MicroRally/uDCCD-Controller/README.md

# uDCCD-Controller
 Simple DCCD controller, based on AVR Tiny
