MicroRally/uDCCD-Controller/Hardware/Main Board/r6/uDCCD_Controller_r6_Schematics.PDF

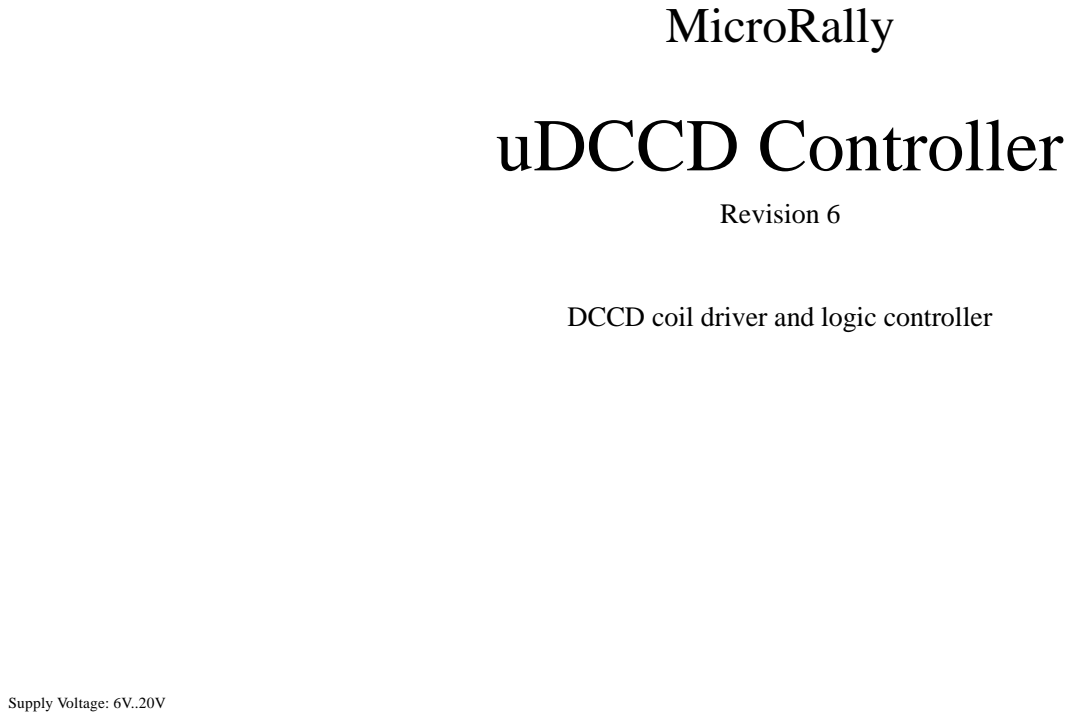
[picture p1: page 1]

DCCD coil driver and logic controller

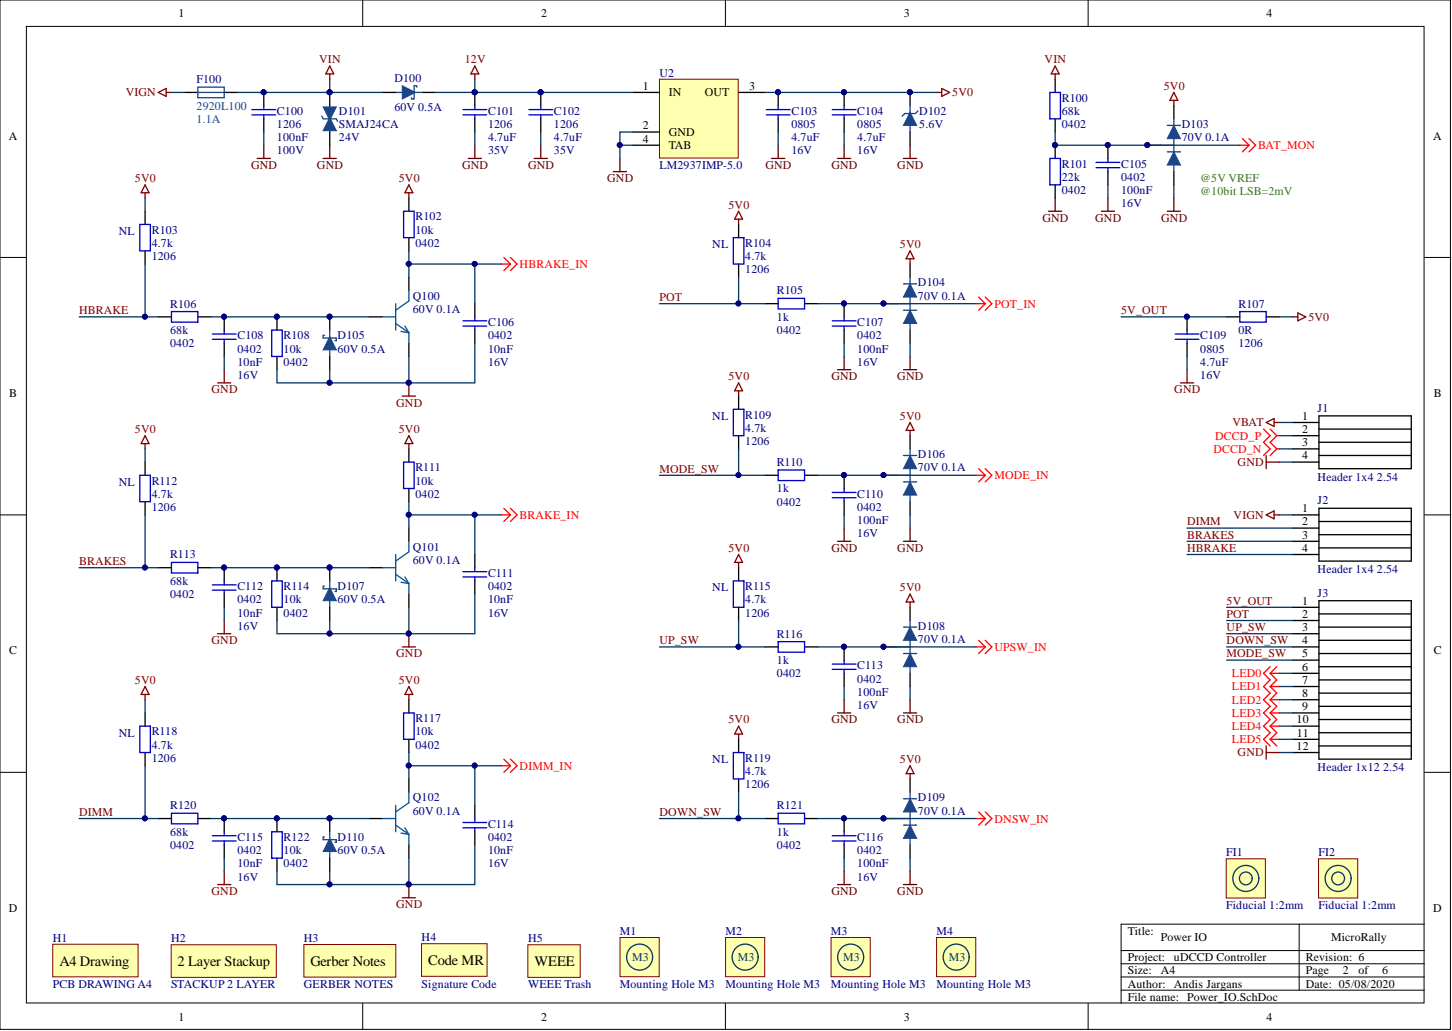
[picture p2: page 2]

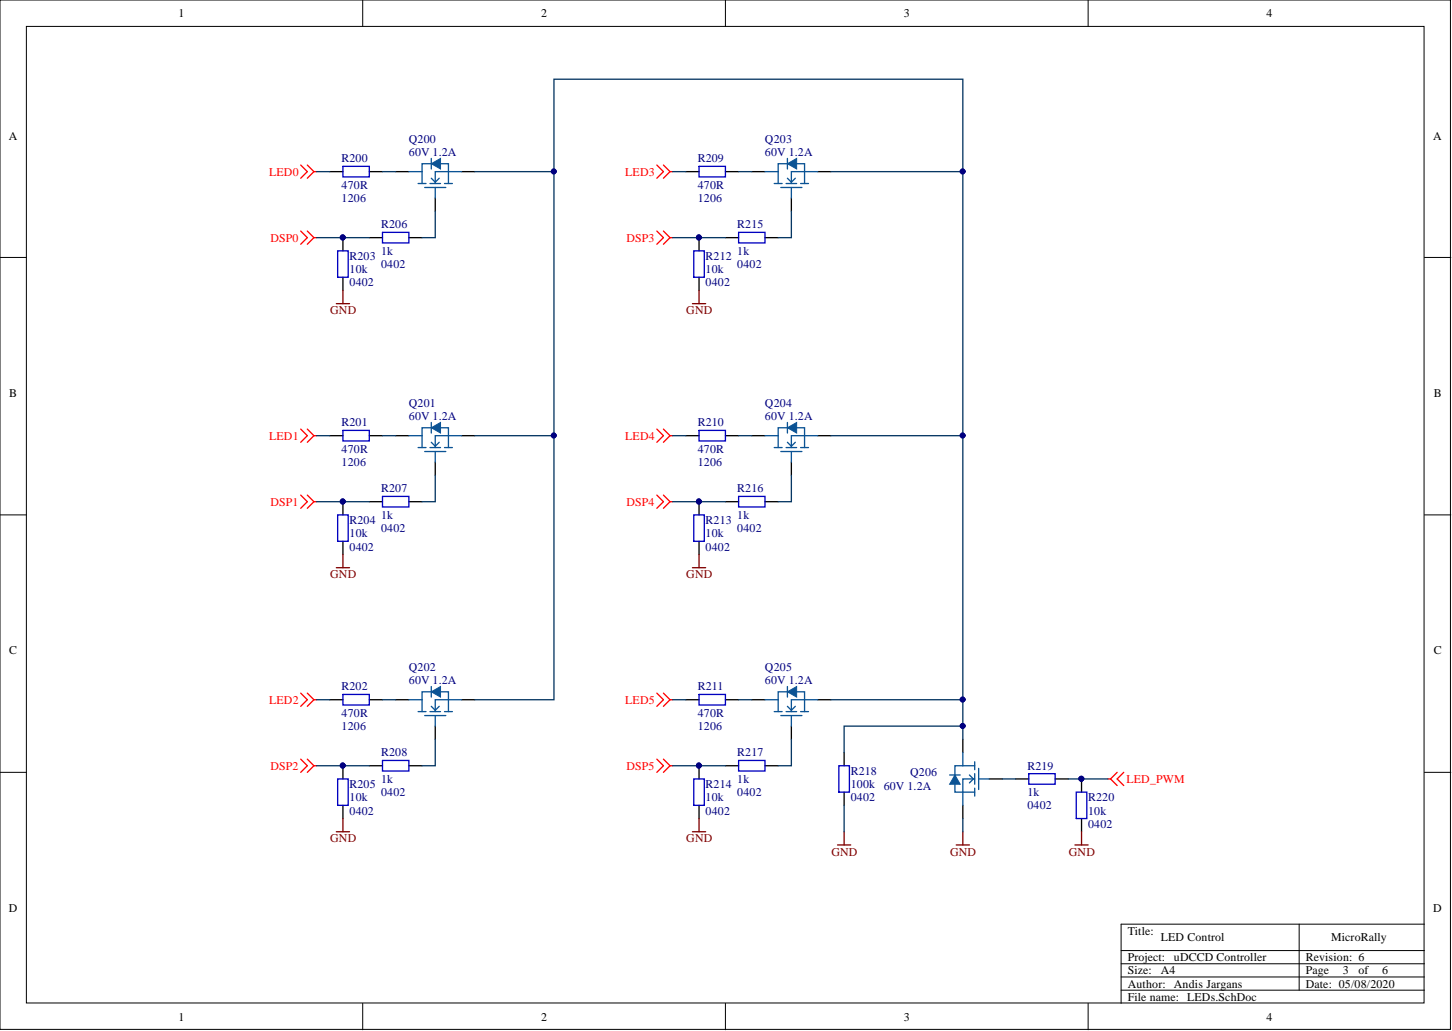
[picture p3: page 3]

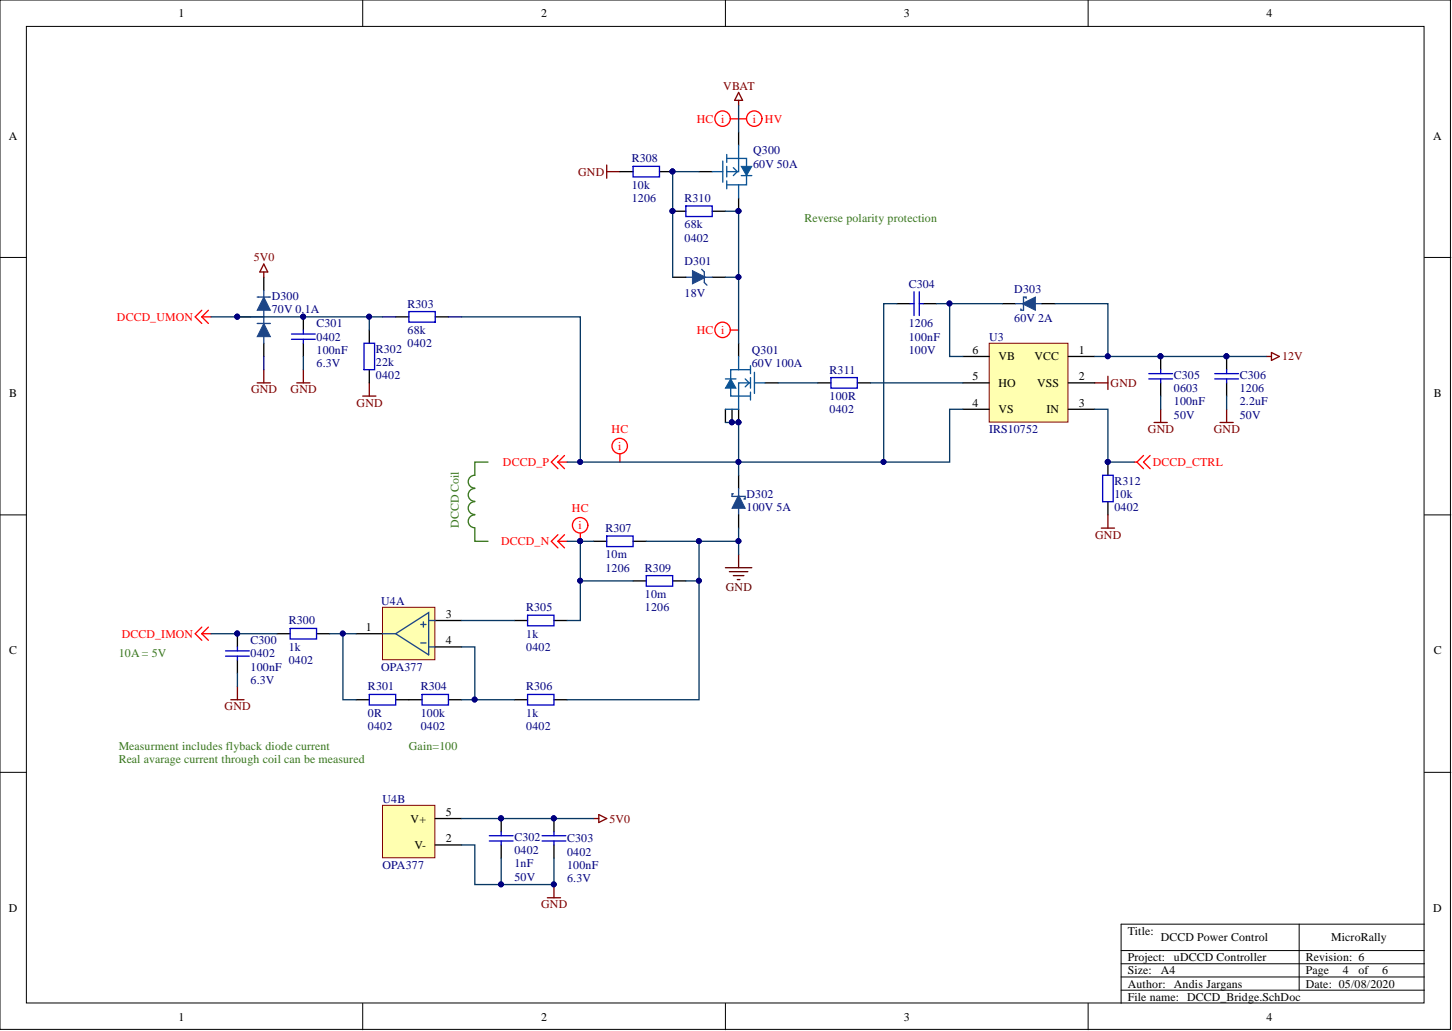
[picture p4: page 4]

Measurment includes flyback diode current
Real avarage current through coil can be measured

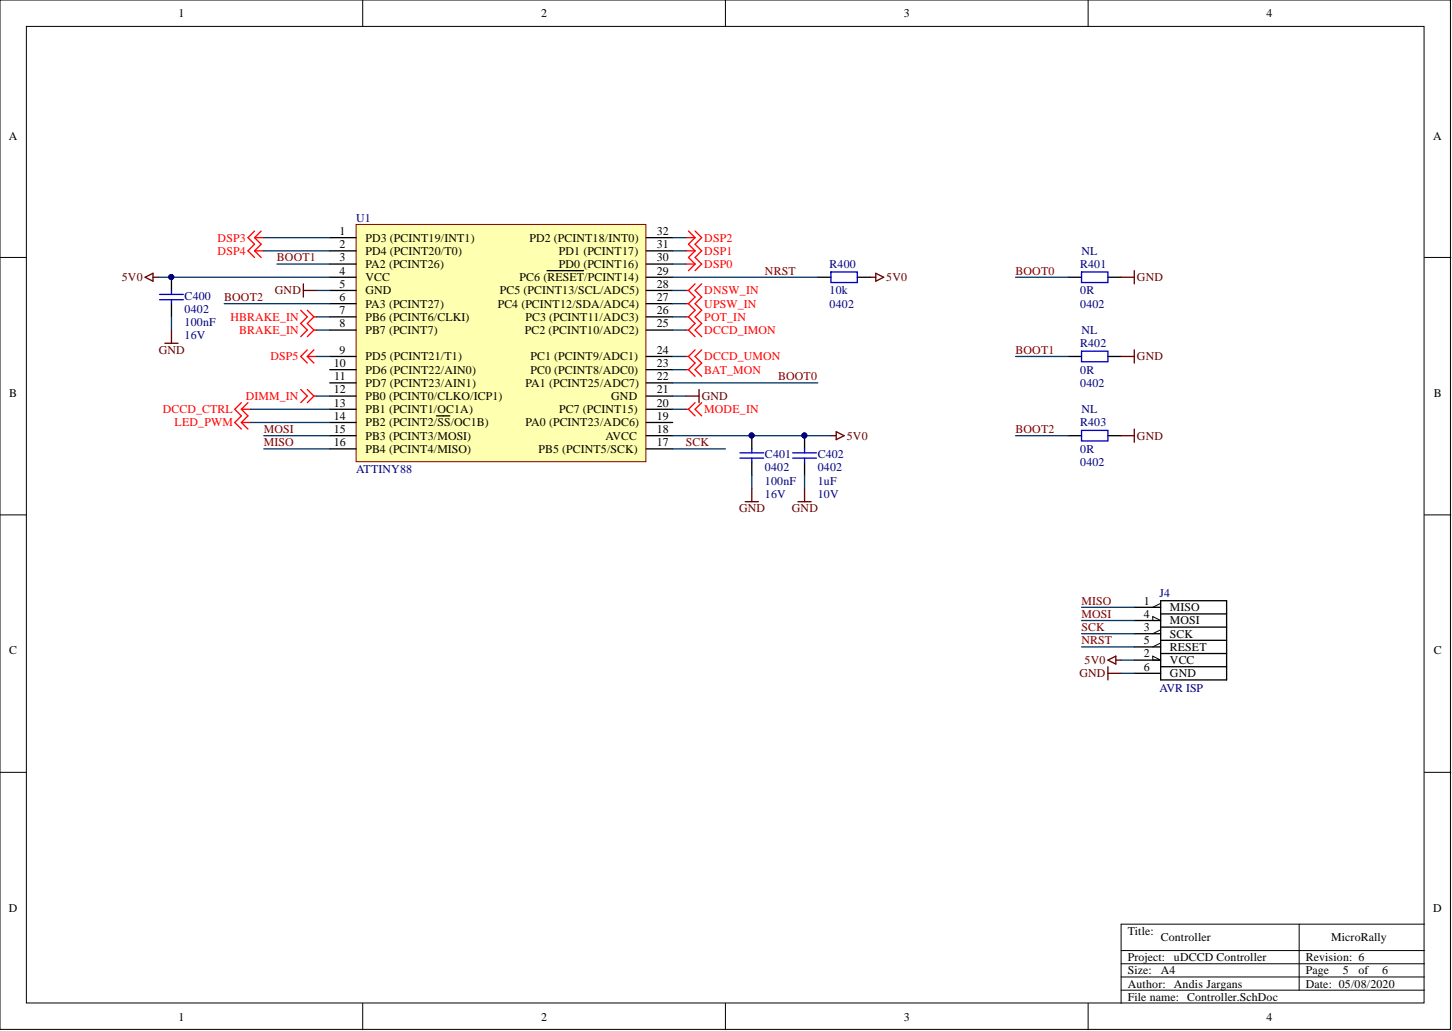
[picture p5: page 5]

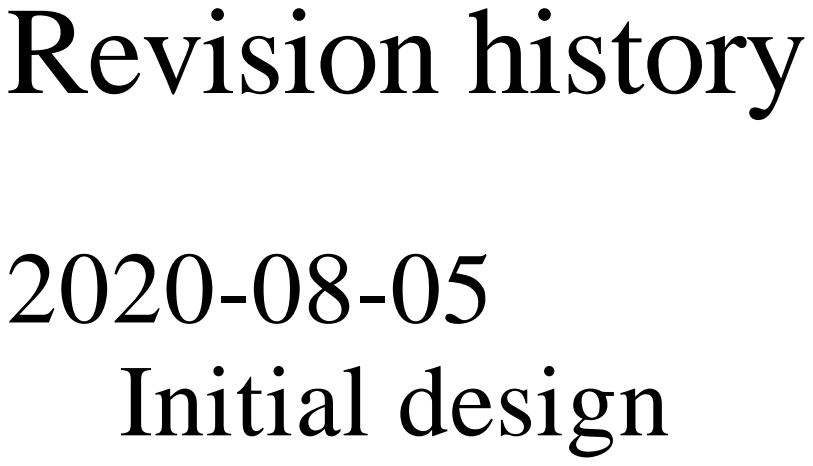
[picture p6: page 6]
