MicroRally/uDCCD-Controller/Hardware/Main Board/r7/uDCCD_Controller_r7_Schematics.PDF

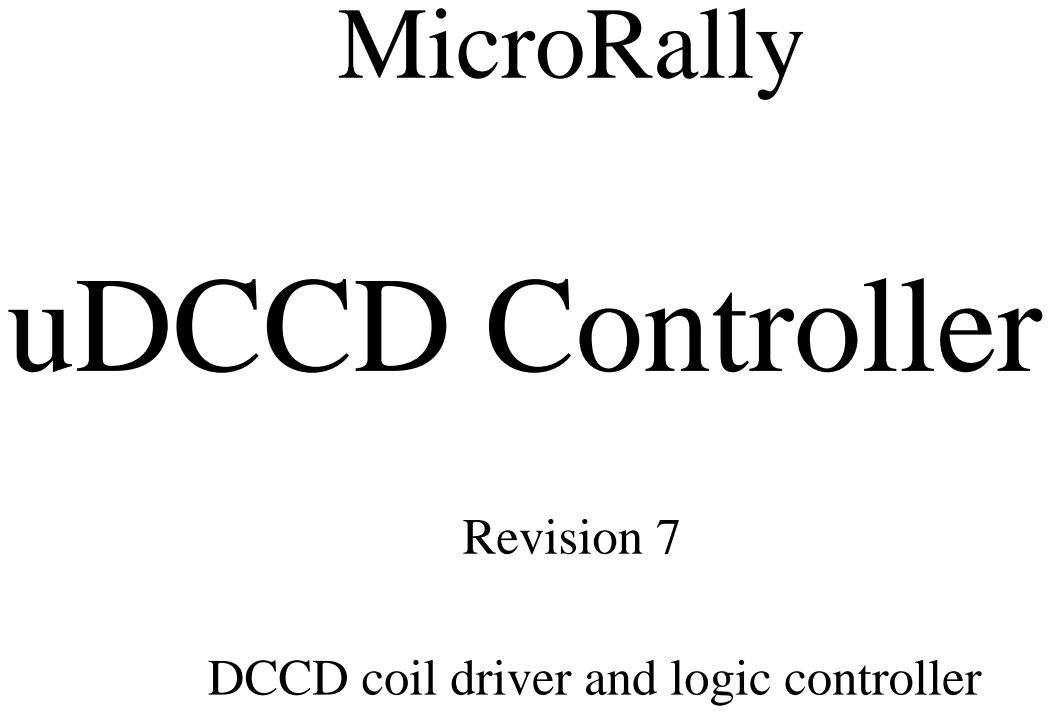
[picture p7: page 1]

DCCD coil driver and logic controller

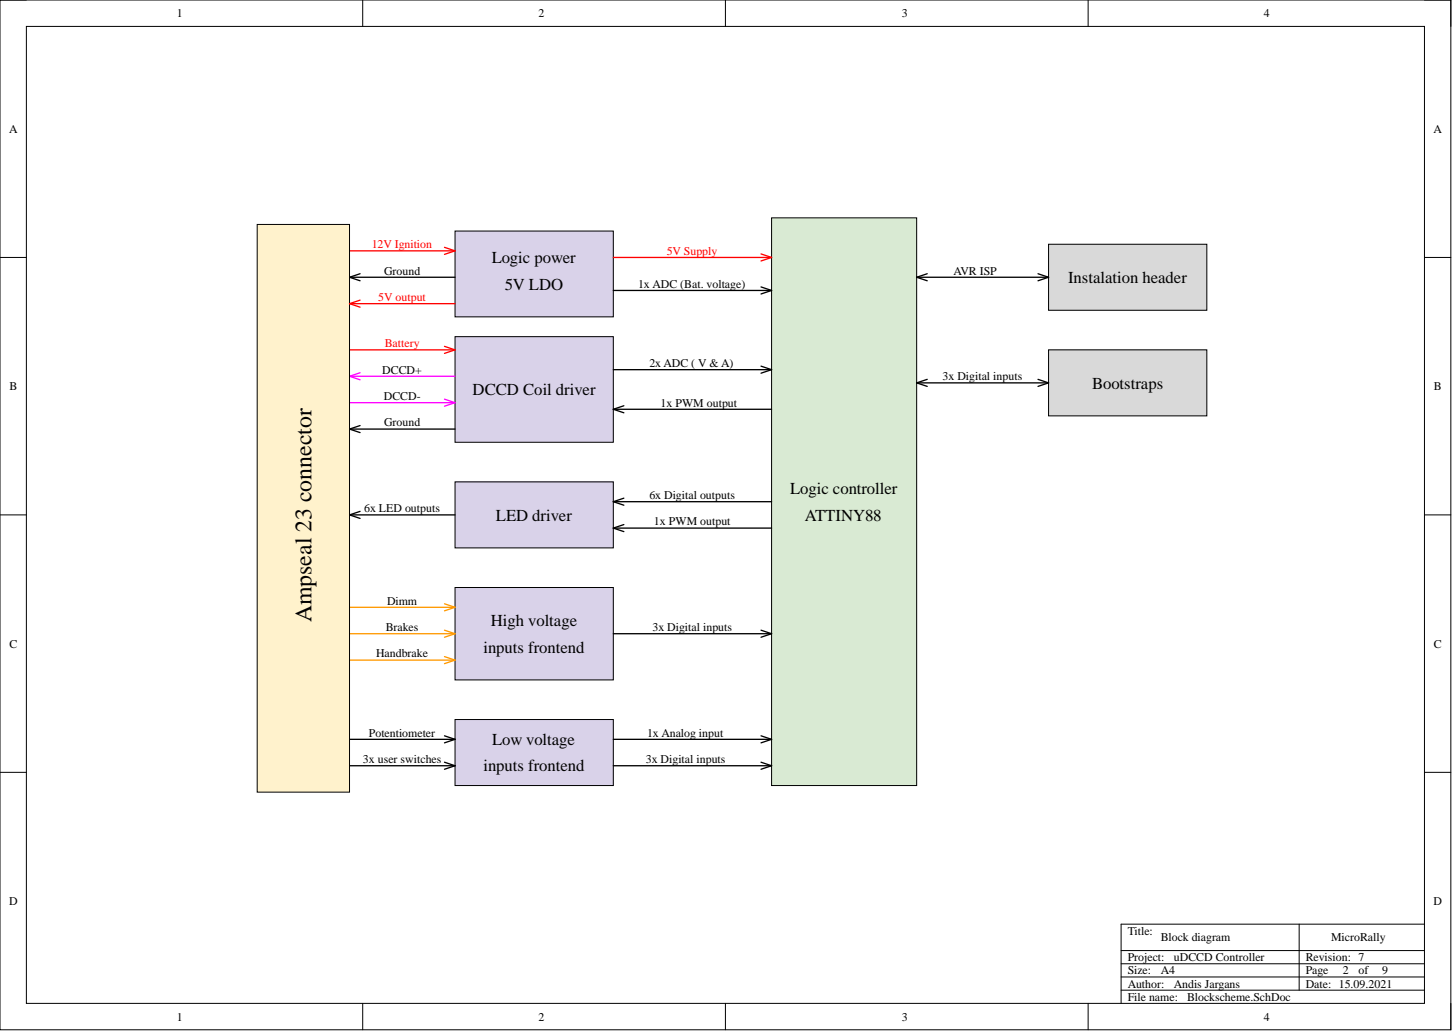
[picture p8: page 2]

Instalation header AVR ISP

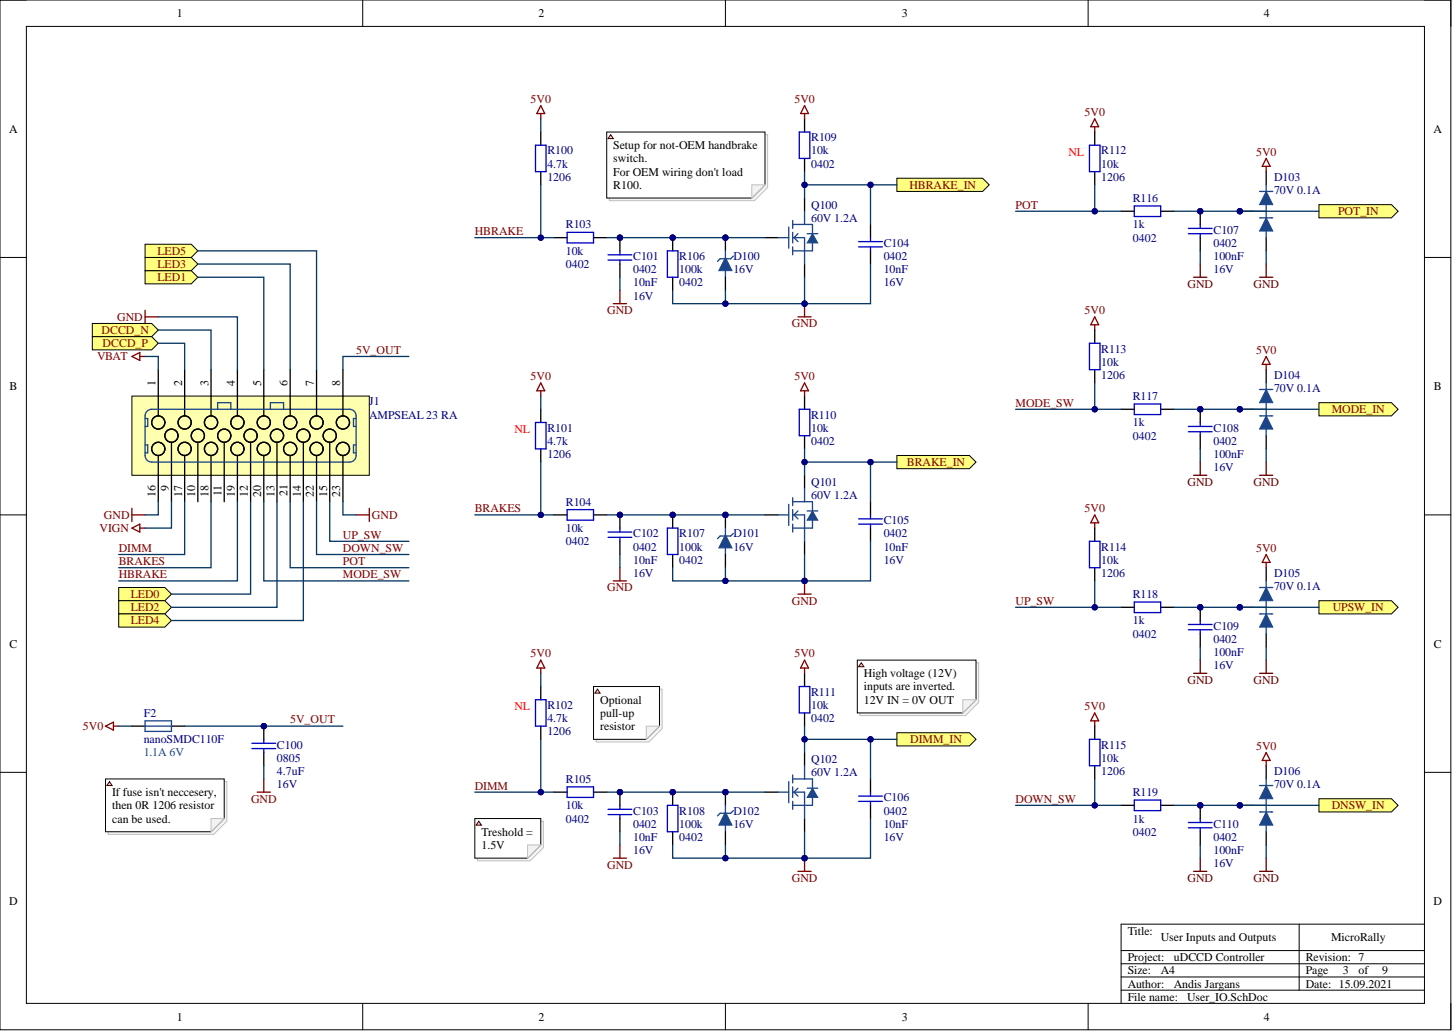
[picture p9: page 3]

Setup for not-OEM handbrak
switch.
For OEM wiring don't load

If fuse isn't neccesery
then 0R 1206 resistor
can be used.

File name: Author: Size:

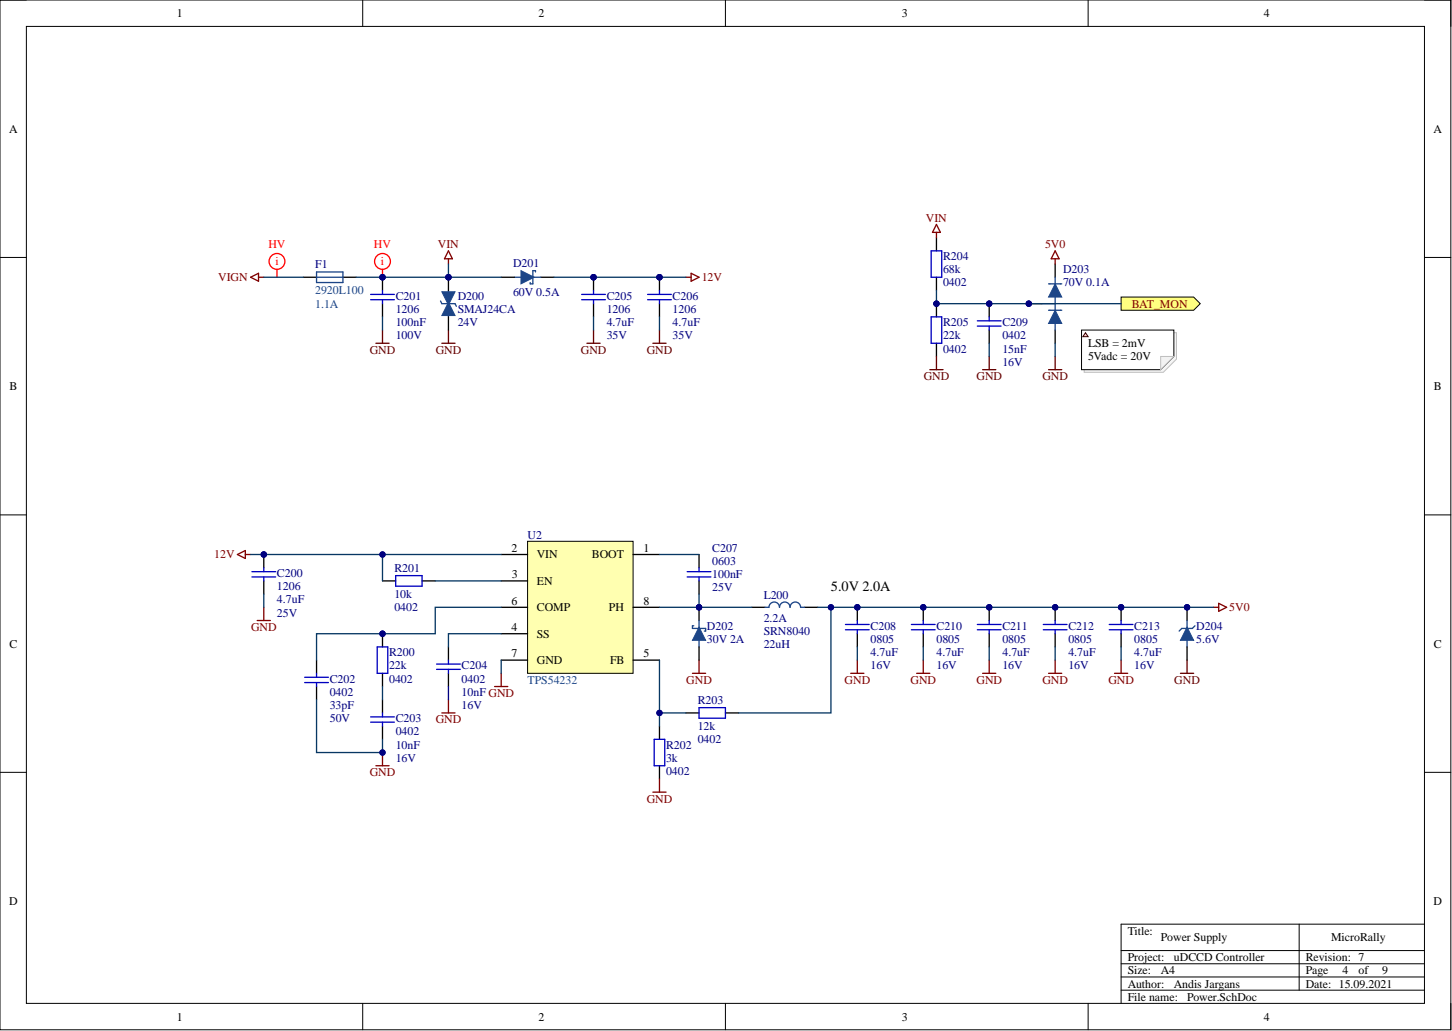
[picture p10: page 4]

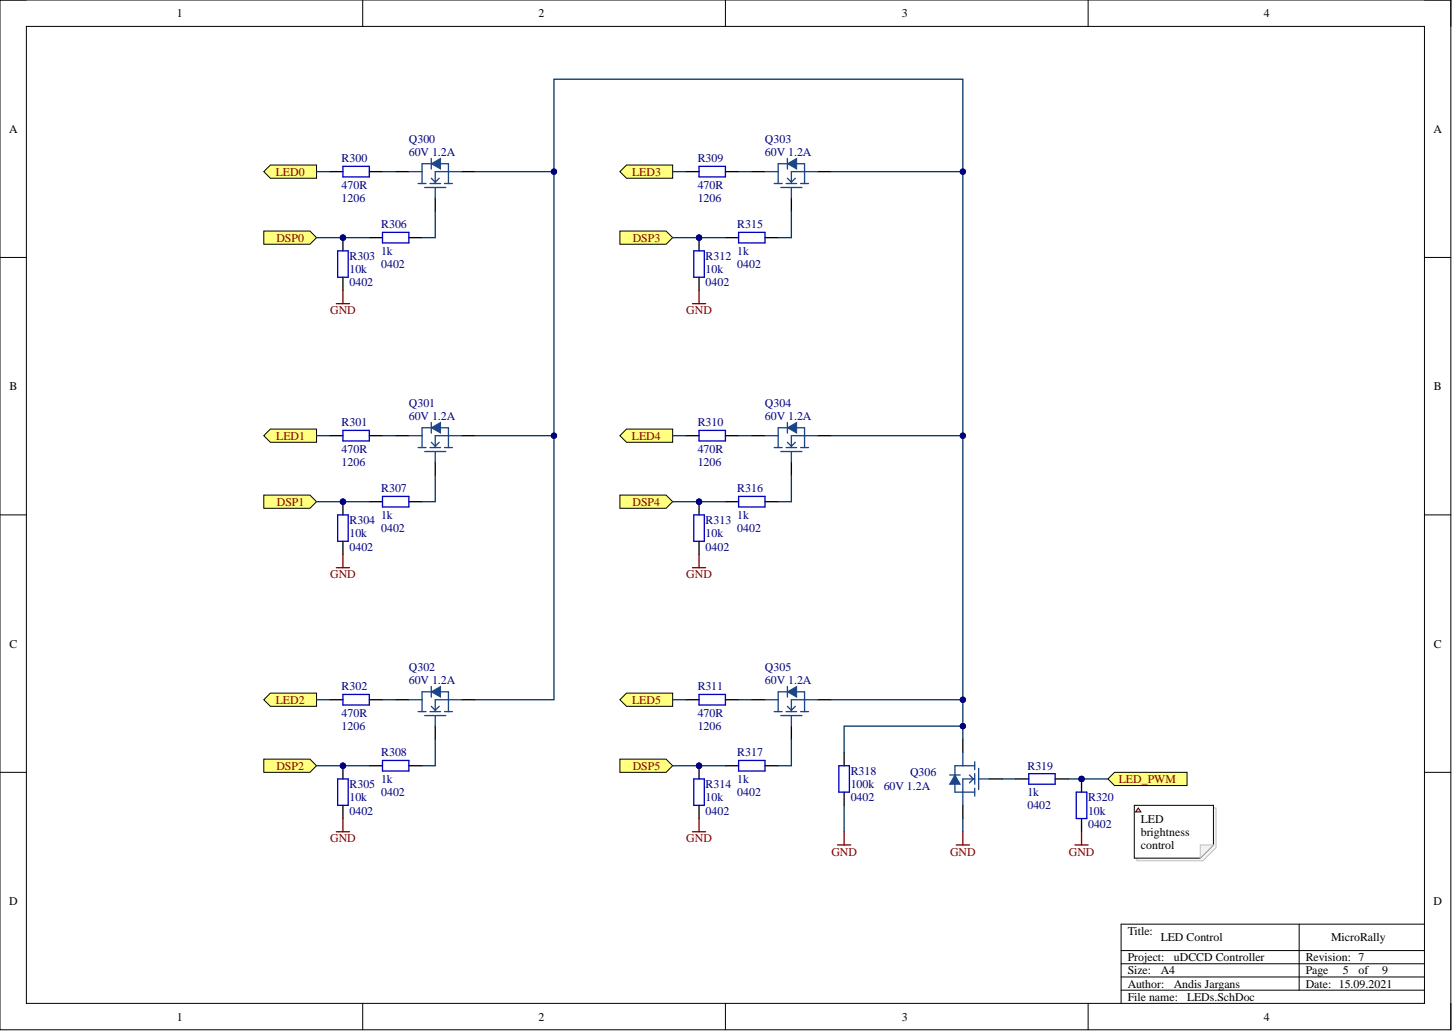
[picture p11: page 5]

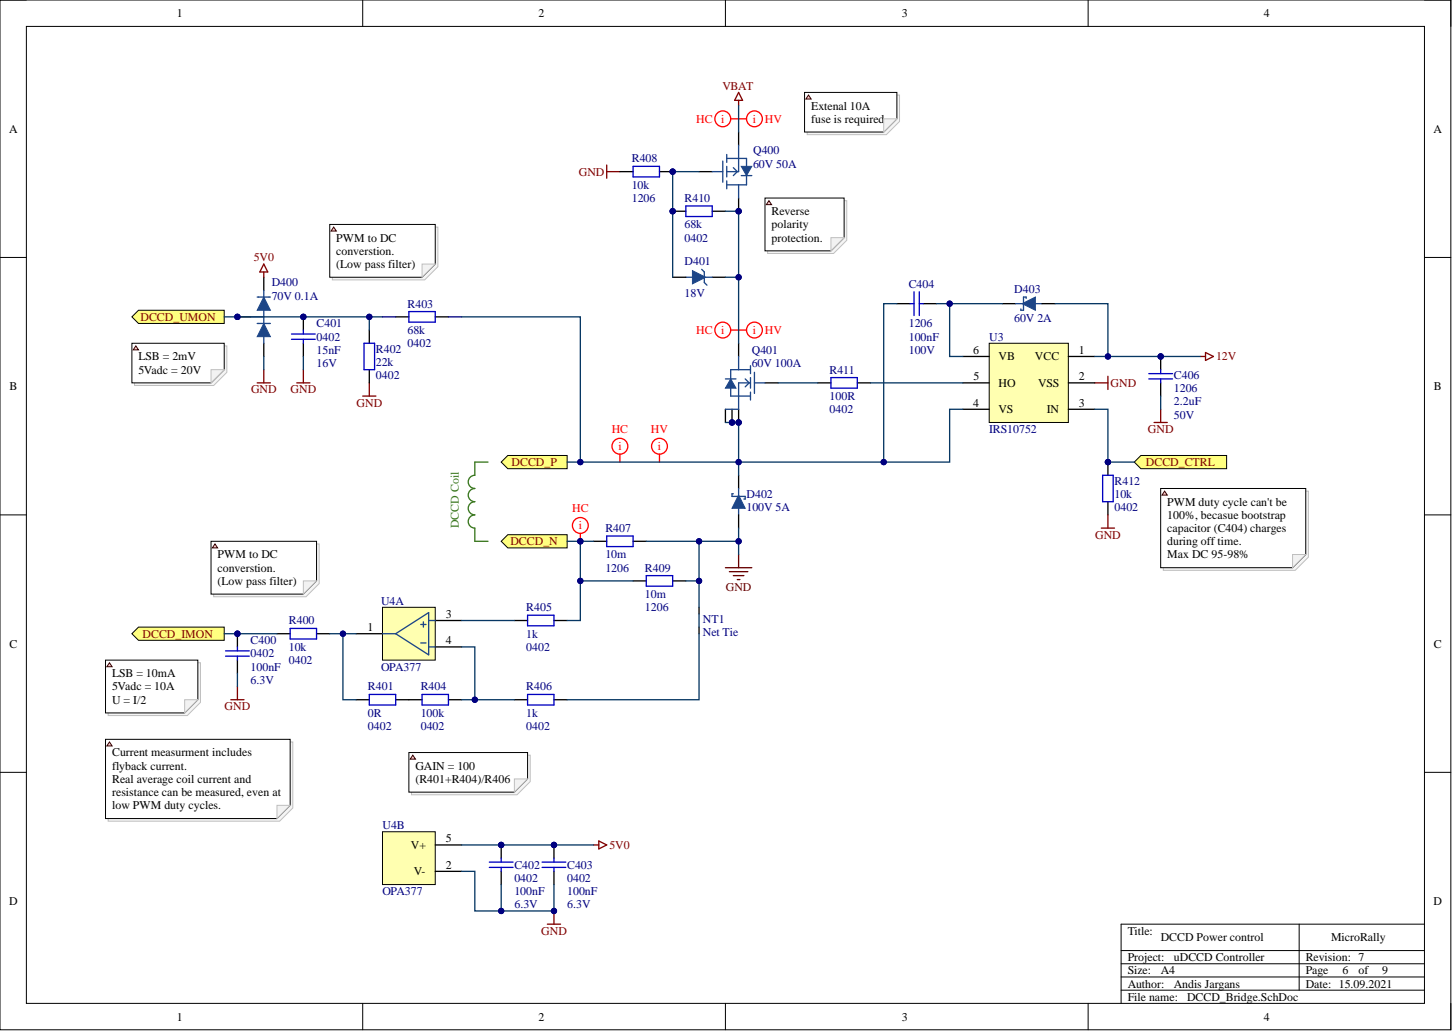
[picture p12: page 6]

PWM duty cycle can't be
100%, becasue bootstrap
capacitor (C404) charges
during off time.
Max DC 95-98%

Current measurment includes
flyback current.
Real average coil current and
resistance can be measured, even at
low PWM duty cycles.

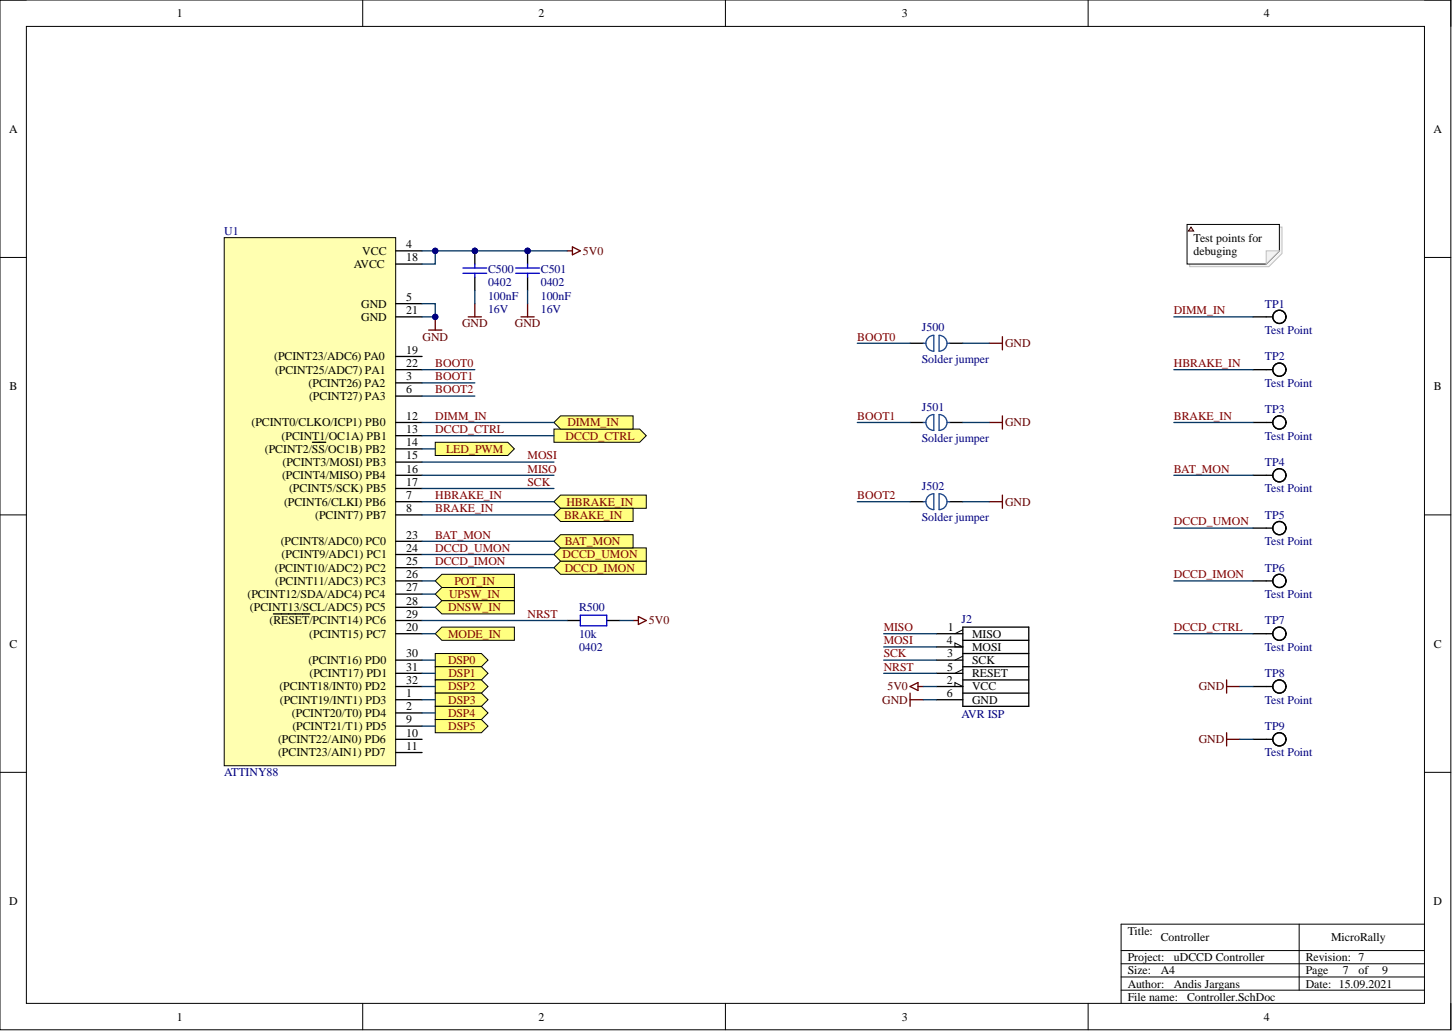
[picture p13: page 7]

GND Test points for
debuging

File name: Author: Size:

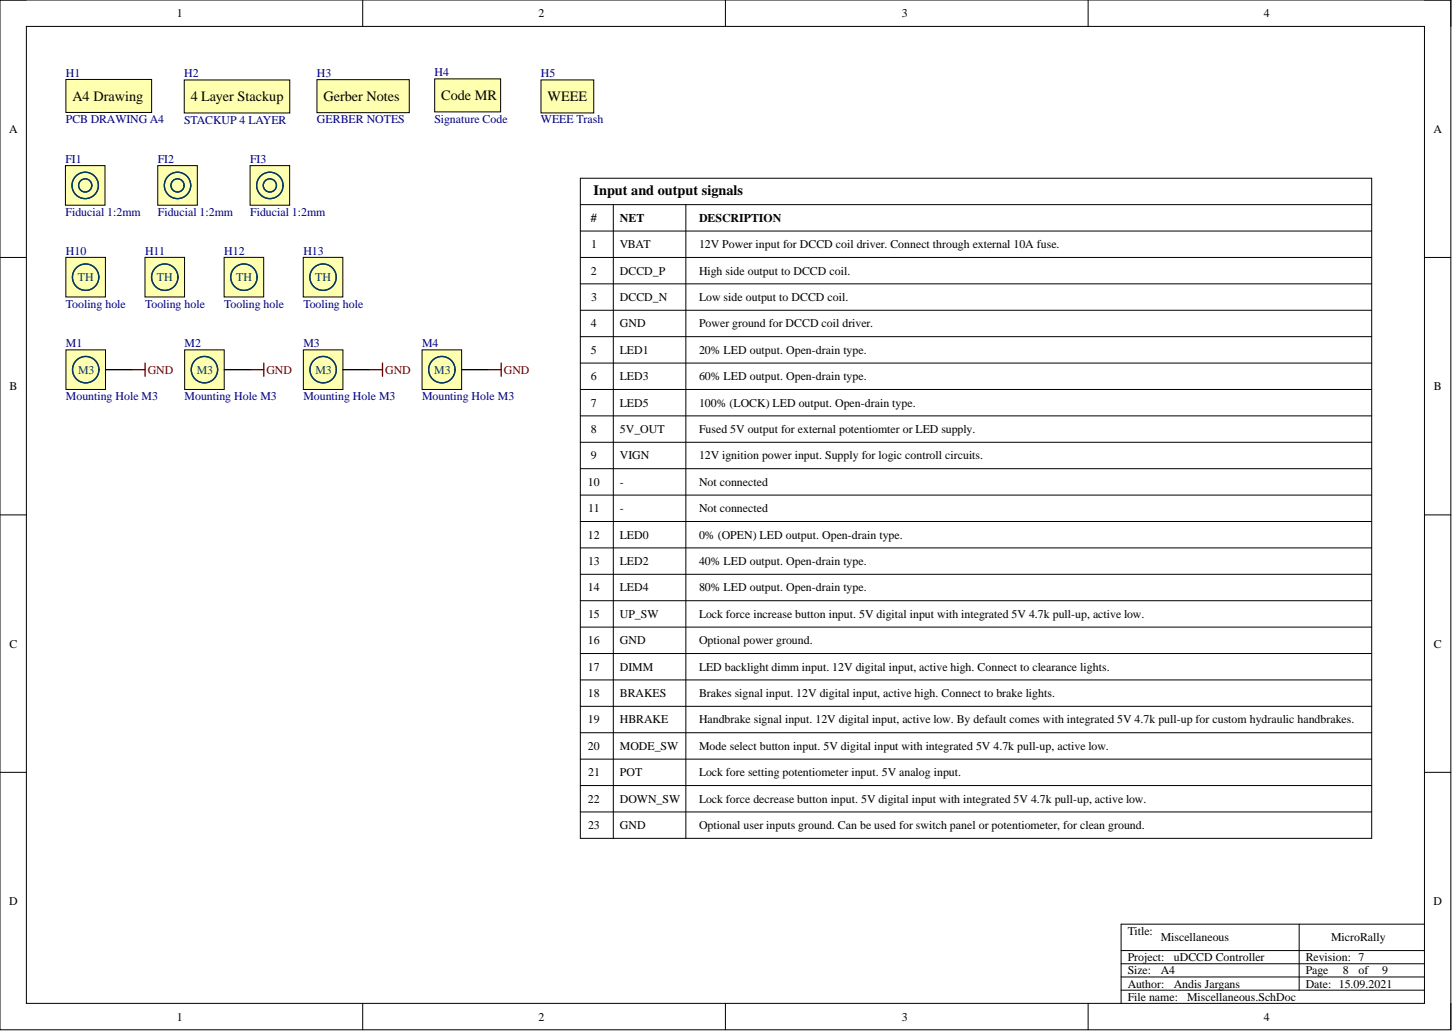
[picture p14: page 8]

Input and output signals

# | NET | DESCRIPTION

1 | VBAT | 12V Power input for DCCD coil driver. Connect through external 10A fuse.

High side output to DCCD coil.

3 | DCCD_N | Low side output to DCCD coil.

4 | GND | Power ground for DCCD coil driver.

5 | LED1 | 20% LED output. Open-drain type.

6 | LED3 | 60% LED output. Open-drain type.

7 | LED5 | 100% (LOCK) LED output. Open-drain type.

8 | 5V_OUT | Fused 5V output for external potentiomter or LED supply.

9 | VIGN | 12V ignition power input. Supply for logic controll circuits.

10 | - | Not connected

11 | - | Not connected

12 | LED0 | 0% (OPEN) LED output. Open-drain type.

13 | LED2 | 40% LED output. Open-drain type.

14 | LED4 | 80% LED output. Open-drain type.

15 | UP_SW | Lock force increase button input. 5V digital input with integrated 5V 4.7k pull-up, active low.

16 | GND | Optional power ground.

17 | DIMM | LED backlight dimm input. 12V digital input, active high. Connect to clearance lights.

18 | BRAKES | Brakes signal input. 12V digital input, active high. Connect to brake lights.

19 | HBRAKE | Handbrake signal input. 12V digital input, active low. By default comes with integrated 5V 4.7k pull-up for custom hydraulic handbrakes.

20 | MODE_SW | Mode select button input. 5V digital input with integrated 5V 4.7k pull-up, active low.

21 | POT | Lock fore setting potentiometer input. 5V analog input.

22 | DOWN_SW | Lock force decrease button input. 5V digital input with integrated 5V 4.7k pull-up, active low.

23 | GND | Optional user inputs ground. Can be used for switch panel or potentiometer, for clean ground.

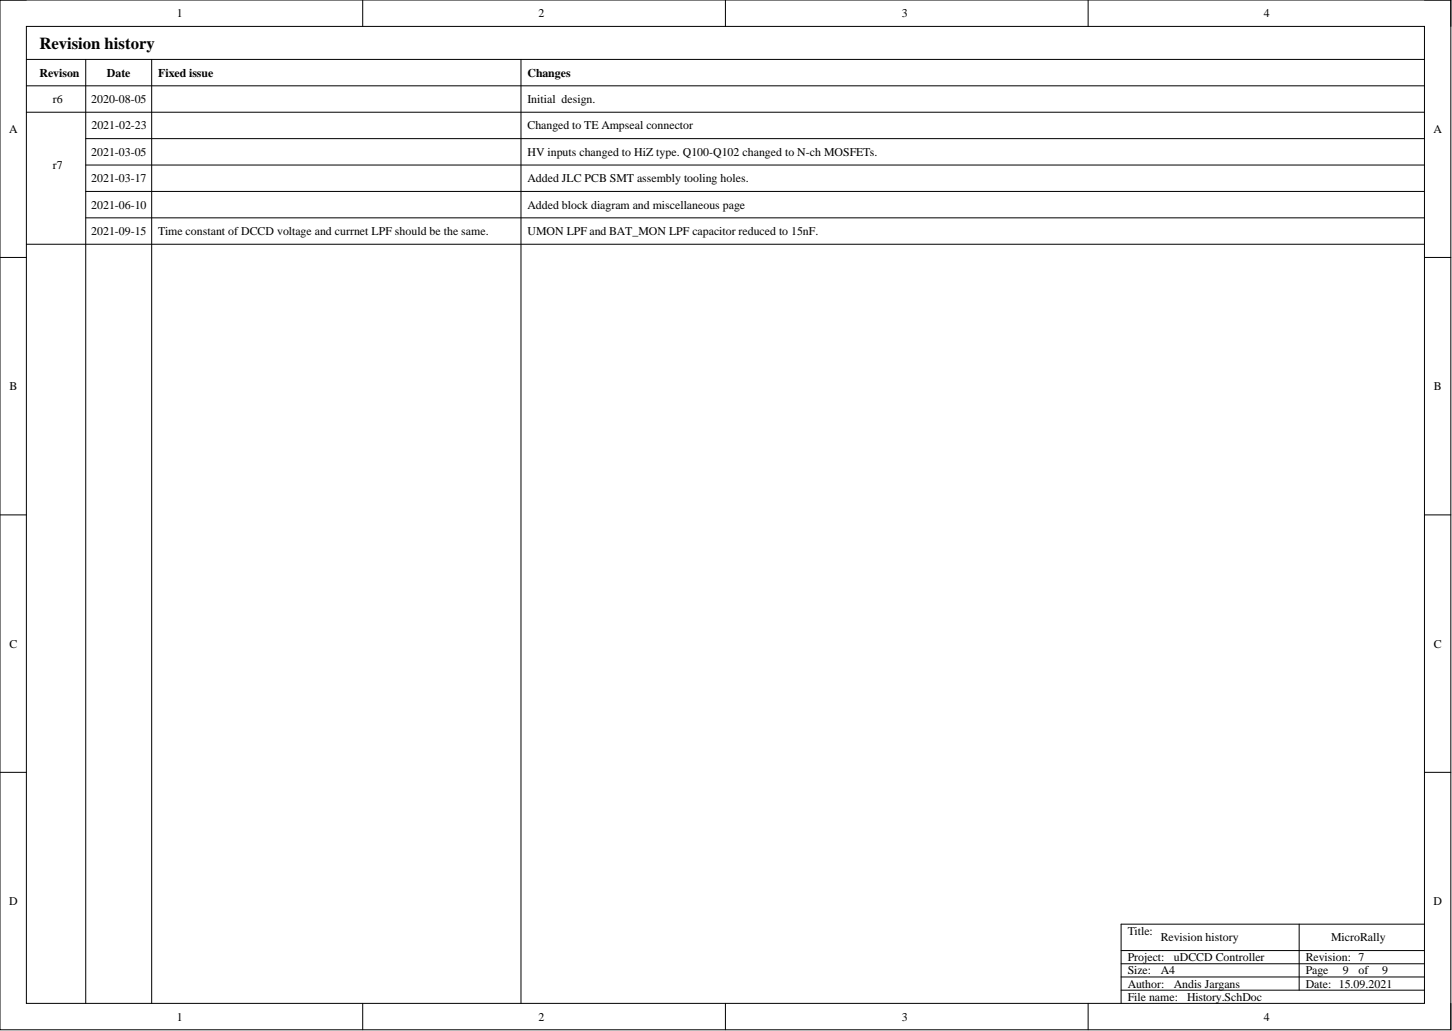
[picture p15: page 9]
