MicroRally/uDCCD-Controller/Hardware/Main Board/r6/uDCCD_Controller_r6_BOM.pdf

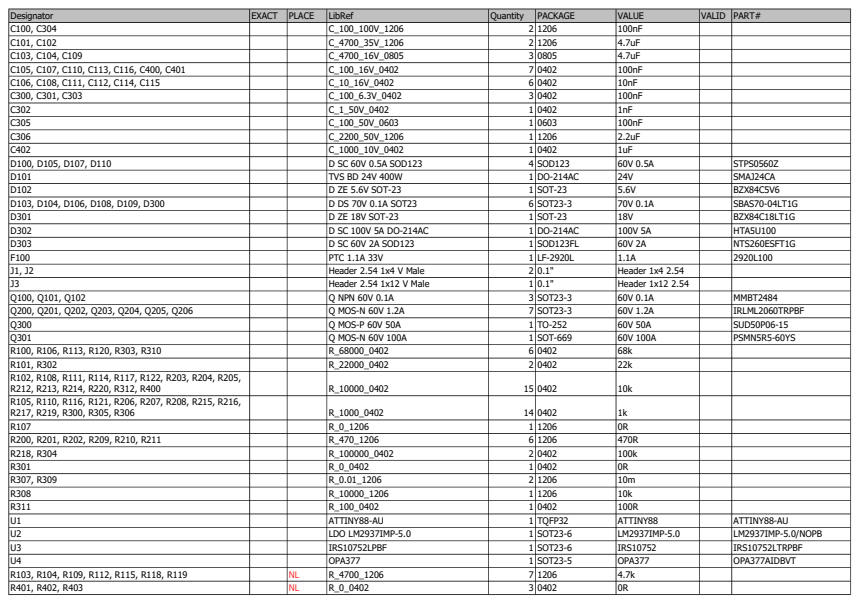
[picture p16: page 1]
