MicroRally/uDCCD-Controller/(commit log)

2021-10-21 Initial commit
    Initial commit
    [uDCCD_Controller_r7_BOM.xlsx, uDCCD_Controller_r7_PNP.csv]
2021-10-21 Outputs HAL updated to match inputs HAL
    Updated outputs HAL, renamed outputs_driver to hal_outputs and updated DCCD and LED drivers to match new file names.
    Removed adc_driver as it is no longer neccesery.
    [dccd_driver.h, hal_outputs.c, hal_outputs.h, leds_driver.c]
2021-10-21 Added inputs driver template
    Inputs driver created
2021-10-23 Inputs driver added
    HAL_inputs:
    Removed pull-up control options, as PORTC pullups are disabled because of ADC.
    Removed unnecessary variables
    Added separate Init/Deinit functions for bootstrap pins
    Inputs Driver;
    Written all functions
    Other files - cleaned comments
2021-10-23 Fixed compilation errors
    Updated project files and fixed compilation errors
    [hal_inputs.c, hal_outputs.c, hal_outputs.h, hw_config.h, inputs_driver.c, leds_driver.c]
2021-12-29 Restructured drivers and HAL
    Decided to write it all different.
2021-12-30 Updated Display driver
    Updated display driver to match new code logic.
2021-12-30 Updated inputs driver
    Updated inputs driver to match new code logic and HAL.
2021-12-30 Fixed drivers compilation errors
    Fixed drivers compilation errors
    [coil_driver.c, display_driver.c, display_driver.h, inputs_driver.c, main.c, udccd_hal.c]
2022-01-03 Added v1 FW and r6 HW files
    Added legacy v1.0 firmware source and main board r6 design files
    [uDCCD_Controller_r7_BOM.xlsx, uDCCD_Controller_r7_PNP.csv]
2022-01-03 Added FW v1.31
    Special version for last of r6 boards
2022-01-03 Added FW v1.32
    Removed protections to increase stability.
    [main.c]
2022-01-03 Added FW v1.33
    Even more reduced protection. Now OPC is fixed value.
    [main.c]
2022-01-03 Added to do and bootstraps moved to inputs driver
